wbinder1/e-paper-esp32-frame/README

# E-paper ESP32 Frame

ESP e-paper frame
ESP e-paper frame

This project offers a comprehensive installation guide for an e-paper picture frame that updates daily. The frame showcases a Waveshare seven-color e-paper display, which, combined with the implemented Floyd-Steinberg Dithering algorithm, creates the illusion of a greater color depth. Users have the ability to convert their own images using the included BMP-Converter. Furthermore, the frame can be connected to the internet to display specific images on designated days.

## Features

- Display BMP images on the e-paper screen.
- Handle SD card operations.
- Manage deep sleep and wake-up functionalities.
- Use preferences to store and retrieve data.

## Table of Contents

- [Components](#components)
- [Installation](#installation)
- [Usage](#usage)
- [Contributing](#contributing)
- [License](#license)

## Components

- FireBeetle 2 ESP32-E: A microcontroller with low power consumption during deep sleep.
- Li-Po 503450 1000mAh 3.7V with PH2.0 connector: A rechargeable lithium polymer battery for power supply. (Dimensions: 5mm (H) x 34mm (W) x 50mm (L))
- Micro SD Card Module: A module for handling micro SD cards. (Dimensions: 18mm x 18mm)
- Waveshare 7.3inch ACeP 7-Color E-Paper E-Ink Display Module + HAT: An e-paper display module with seven colors, SPI communication, featuring 800×480 pixels.
- Toggle Switch (Optional): A switch used to turn off the power from the battery. (Thread diameter: 5mm)
- Printed Case: A 3D printed case to hold all the components.
- Four Heat Inserts and Screws: Hardware components for assembly.
- Picture frame: A standard picture frame that can accommodate the e-paper frame.

## Installation

1. Clone the repository:
	```sh
	git clone https://github.com/yourusername/e-paper-esp32-frame.git
	```
2. Open the project in Visual Studio Code or another prefered IDE.

## Usage

1. Connect your ESP32 to the e-paper display and SD card module following the "Schematic for Components.png".
2. Upload the code to your ESP32.
3. Convert the images you want to display using the BMP-Converter. See [Convert the images](#convert-the-images). This application can convert most image formats to BMP format with the correct dimensions of 800 x 480 px, which is needed for the microcontroller to display the image. It also provides basic operations to modify the images.
4. Add the converted images to the SD card, including the info.txt file.
5. (Optional) Copy the setup.json file to the SD card and set the SSID and password in the file. This allows the ESP32 to connect to the internet. The current date will be pulled from an ntp server, to update the image based on the date specified in the filename using the BMP-Converter. With internet connectivity, the ESP32 will update the image at approximately 10 o'clock. Without internet, the ESP32 will sleep for 24 hours (based on the internal clock) and update the image based on name sorting.
6. Print the case using a 3D printer.
7. (Optional) Create a small hole, for example using a soldering iron, between the battery and ESP32 to integrate a toggle switch.
8. Attach the 3D printed case to the backplate of the picture frame by creating a small slit on the top. You can either glue the case to the backplate or use screws to secure them together. On the opposite side, mount the e-paper display. Connect the ribbon cable of the e-paper to the case through the created slit. For a perfect fit, use the provided `passepartout.pdf` file.

### Convert the images

To convert the images, start the BMPConverter application following these steps:

1. Navigate to the `/bmpConverter/build` directory.
2. Run the `converter.exe` executable.

Alternatively, run it like this:
1. Navigate to the `/bmpConverter` directory.
2. Read the `README` in the directory and install requirements.
3. Run `converter.py`.

## Contributing

Contributions are highly appreciated! Feel free to open an issue or submit a pull request. A big thank you to TreeSparrow69 for their valuable contributions to this project.

## License

This project is licensed under the MIT License.
