wbinder1/e-paper-esp32-frame/bmpConverter/README.md

# bmp-Converter

This is a Python script for converting BMP images to a format compatible with this e-paper project.

## Python Requirements

1. To install the required dependencies, follow these steps:

Install the requirements:
  ```
  pip install -r requirements.txt
  ```

2. To save the required dependancies, follow these steps:

Save the currently needed imports in `requirements.txt`:
  ```
  pip install pipreqs
  pipreqs --force
  ```

## Building the Executable

To create an executable file, run the following command:
  ```
  python build.py build
  ```
