wbinder1/e-paper-esp32-frame/3D_modell/PictureFrameV4_Eng.FCStd

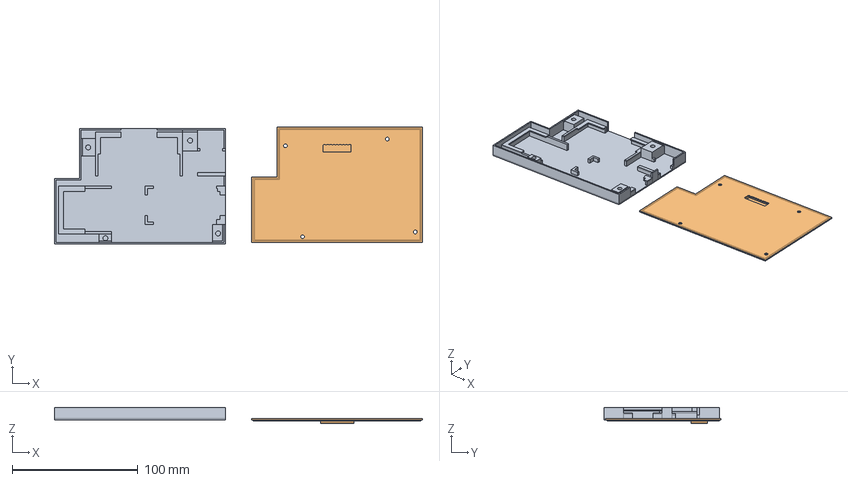
[picture p6: CAD file, 2024-10-10]
3D_modell/PictureFrameV4_Eng.FCStd
293.1 x 93.2 x 13.0 mm
Lid
