wbinder1/e-paper-esp32-frame/3D_modell/PictureFrameV4-Lid.stl

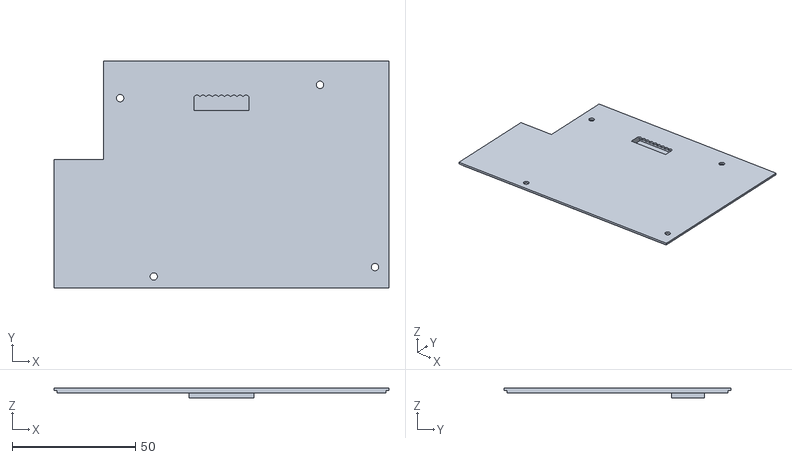
[picture p8: CAD file, 2024-10-10]
3D_modell/PictureFrameV4-Lid.stl
136.0 x 92.0 x 4.00
