wbinder1/e-paper-esp32-frame/normal_operation_interface.html

📱 Normal Operation Interface - What users see after WiFi setup

# 🖼️ E-Paper Frame Status

### 📊 System Status

WiFi Connection: Connected

IP Address: 192.168.1.105

Signal Strength: -45 dBm (Excellent)

Battery Level: 3.8V (Good)

Uptime: 2 days, 14 hours

Last Update: Today at 9:00 AM

### 🖼️ Current Display

Current Image: 001_15.12.2024_family_photo.bmp

Next Image: 002_16.12.2024_sunset.bmp

Next Update: Tomorrow at 9:00 AM

Images on SD Card: 24 files

### ⚙️ Controls

Display Controls: 🔄 Refresh Display ⏭️ Show Next Image ⏮️ Show Previous Image

System Controls: 🔄 Check for Updates 🔄 Restart Device 🔌 Reset WiFi Settings

💡 Tip: The e-paper display only updates when needed to save battery. Manual refresh will update the display immediately but use more power.
