wbinder1/e-paper-esp32-frame/setup_instructions.bmp

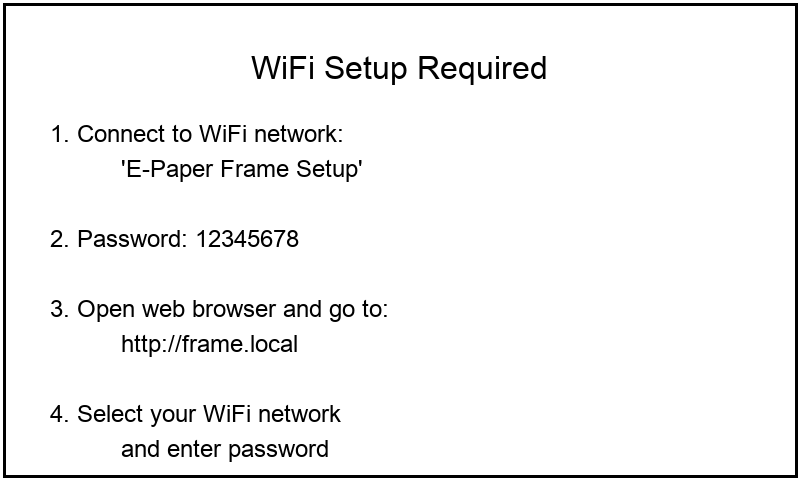
setup_instructions.bmp
