wbinder1/e-paper-esp32-frame/(commit log)

2024-02-28 SPI bus fix
2024-02-28 Added Floyd–Steinberg dithering
2024-02-28 fixed Floyd–Steinberg dithering
2024-03-04 Added loop for sd-card mount
2024-03-05 Flipped the bmp image
    [e-paper-esp32-frame.ino]
2024-03-19 buttons fertig
2024-03-24 Adde buttonpress functions
2024-03-25 Added reset button and some other things
2024-03-26 Add background color to frames and buttons broken
2024-05-15 Update button colors and add background colors to improve UI
2024-09-04 Updates Schematic
2024-09-06 Fixed sleep time calculation
    [e-paper-esp32-frame.ino, time_utils.cpp]
2024-09-23 Updated Schematic
2024-10-09 Added Passepartout, not dunctioning battery indication and backup.json
2024-10-10 docs: Update README with 3D printer instructions
    [PictureFrameV4-Bodyl.stl, PictureFrameV4-Lid.stl, PictureFrameV4_Eng.FCStd]
2025-04-02 Removed battery indicator and added more delay after transistor up
2025-06-17 Added battery level back and DISPLAY_TYPE for easy switching between f and e display
2025-07-11 Add production-ready tabbed web interface and backend integration for ESP32 e-paper frame
